nguyminhdc78-del/airpresenter-s3/enclosure/preview/bottom-shell.png

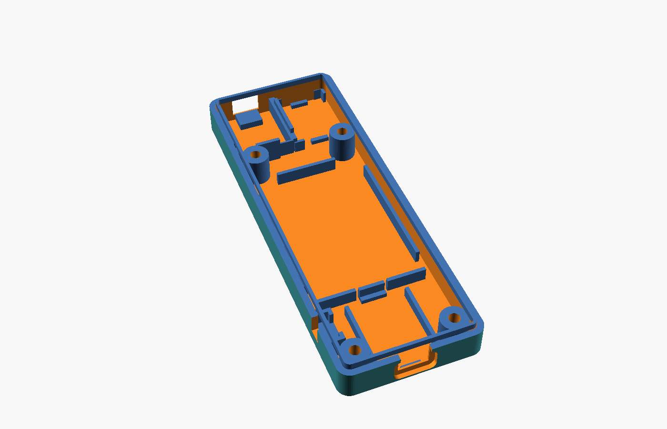
enclosure/preview/bottom-shell.png
