nguyminhdc78-del/airpresenter-s3/enclosure/preview/button-caps.png

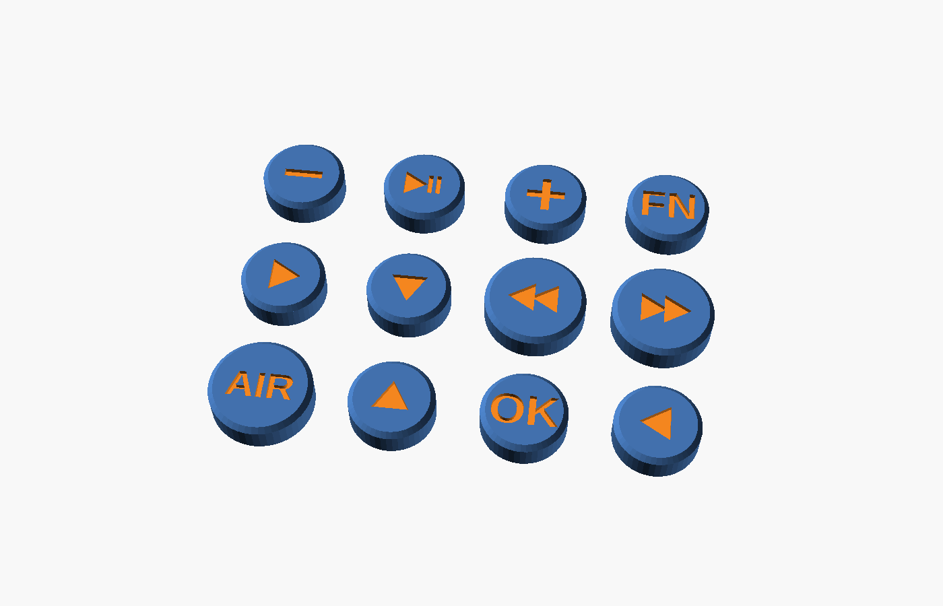
enclosure/preview/button-caps.png
