nguyminhdc78-del/airpresenter-s3/enclosure/preview/button-socket-section.png

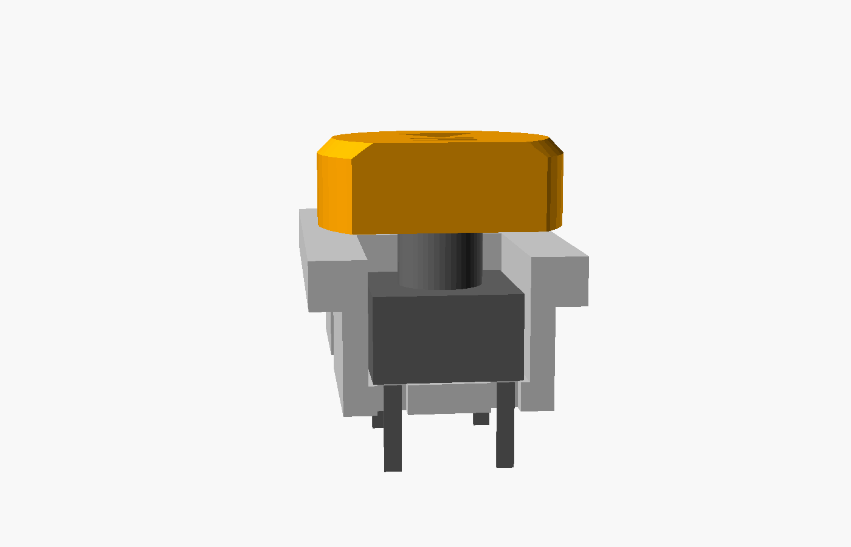
enclosure/preview/button-socket-section.png
