nguyminhdc78-del/airpresenter-s3/enclosure/preview/esp32-cradle.png

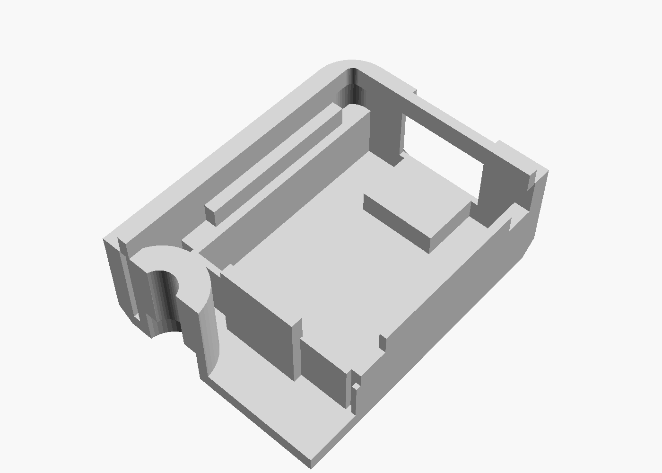
enclosure/preview/esp32-cradle.png
