nguyminhdc78-del/airpresenter-s3/enclosure/preview/esp32-mount-section.png

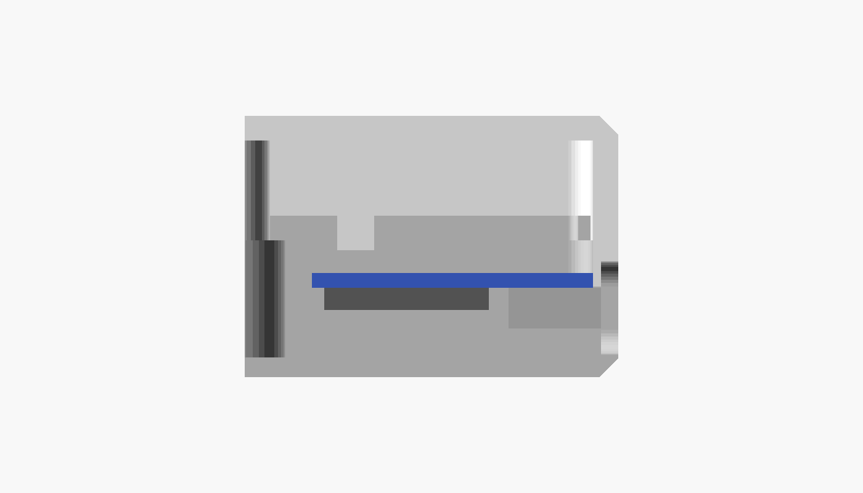
enclosure/preview/esp32-mount-section.png
