nguyminhdc78-del/airpresenter-s3/enclosure/preview/esp32-width-section.png

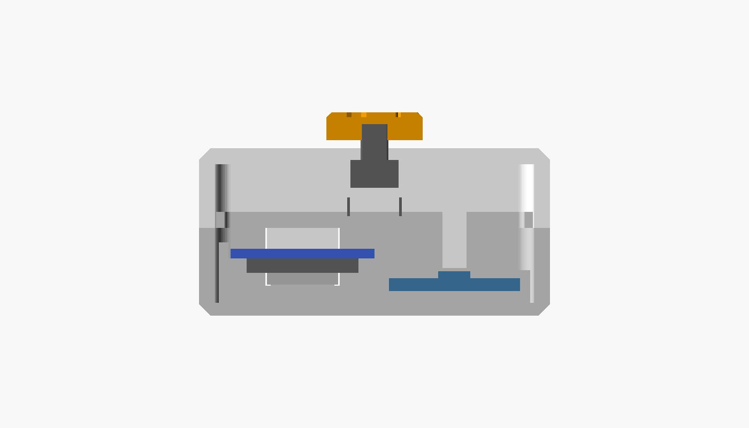
enclosure/preview/esp32-width-section.png
