nguyminhdc78-del/airpresenter-s3/enclosure/preview/exploded.png

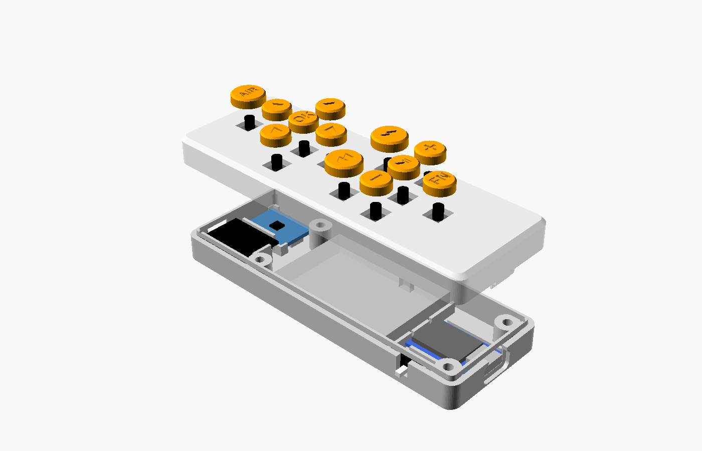
enclosure/preview/exploded.png
