nguyminhdc78-del/airpresenter-s3/enclosure/preview/layout-top.png

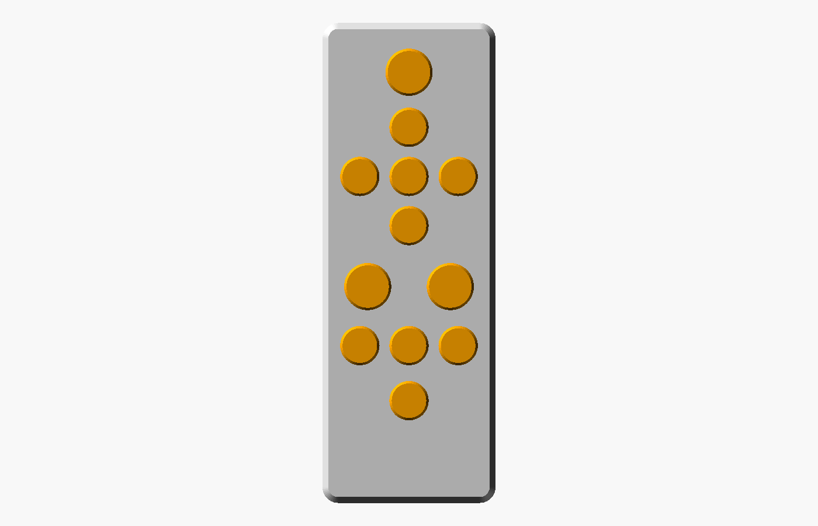
enclosure/preview/layout-top.png
