nguyminhdc78-del/airpresenter-s3/enclosure/preview/top-shell-underside.png

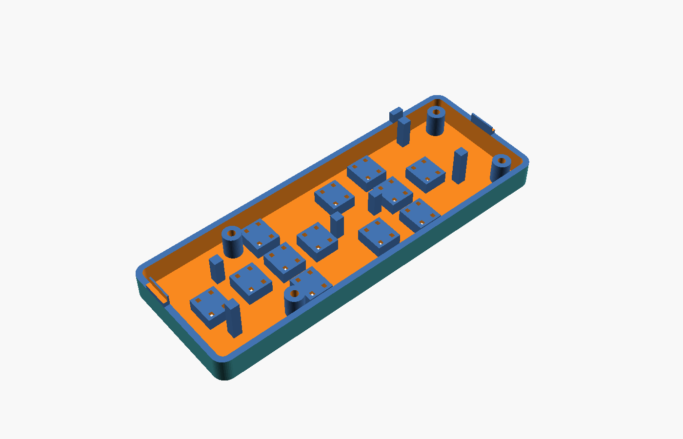
enclosure/preview/top-shell-underside.png
