nguyminhdc78-del/airpresenter-s3/product_image/5851bc56-0efb-418d-aecd-67ae6a5f5945.jpeg

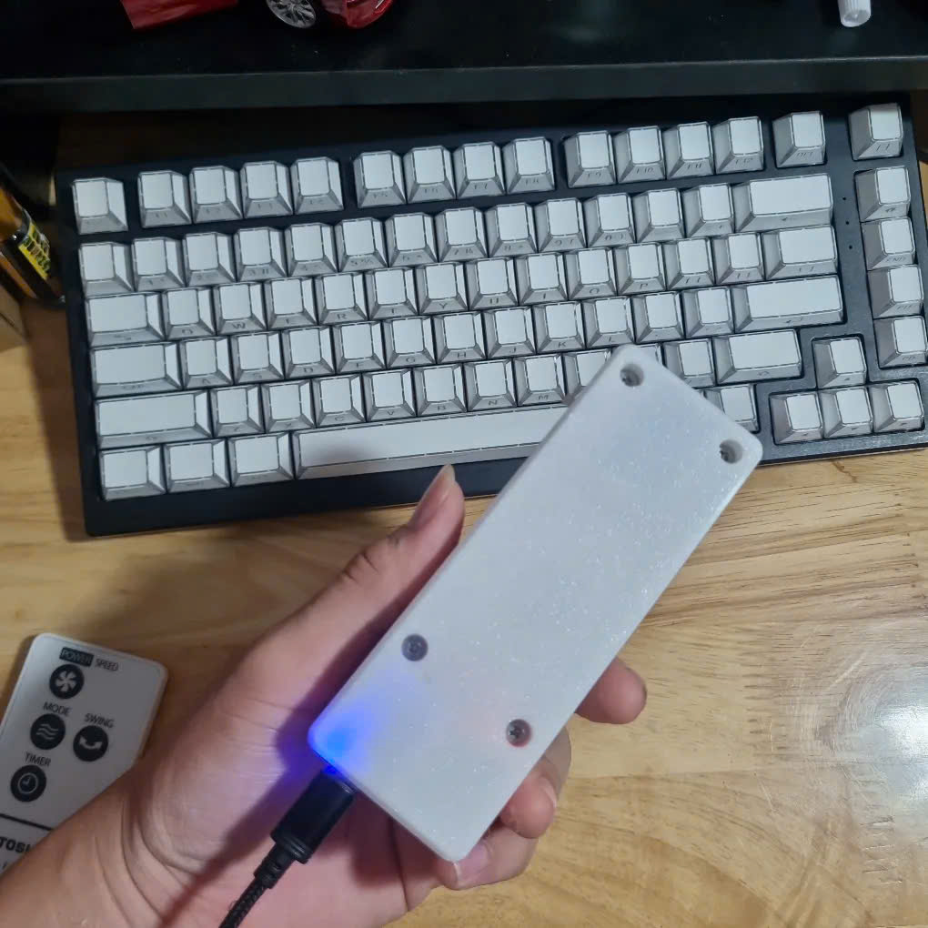
product_image/5851bc56-0efb-418d-aecd-67ae6a5f5945.jpeg
