nguyminhdc78-del/airpresenter-s3/enclosure/step/top-shell.step

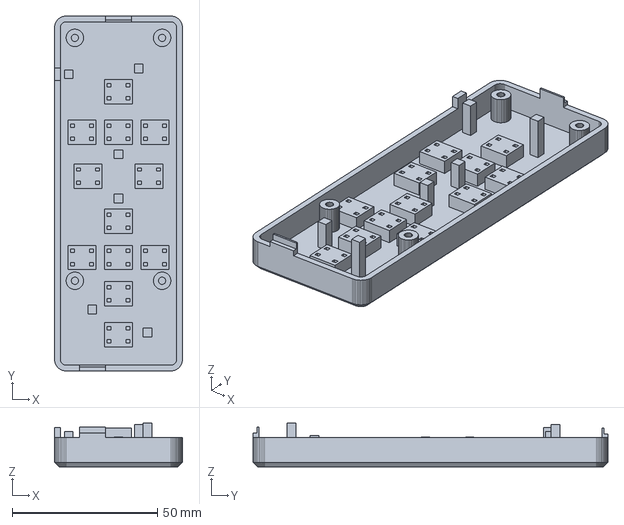
[picture p13: CAD file, 2026-10-25]
enclosure/step/top-shell.step
44.0 x 122.0 x 15.0 mm
