nguyminhdc78-del/airpresenter-s3/enclosure/stl/fit-test-coupon.stl

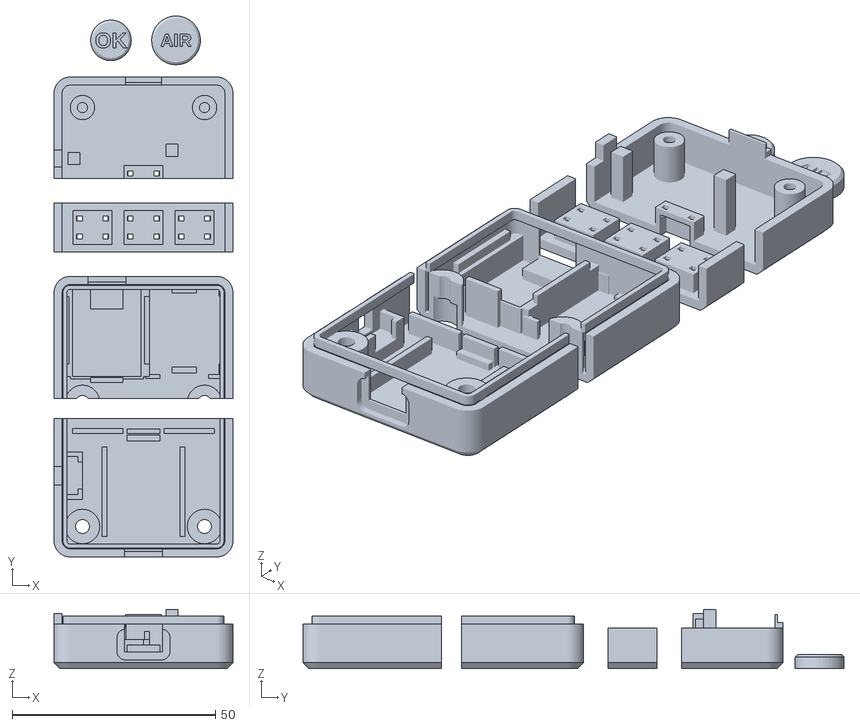
[picture p14: CAD file, 2026-10-25]
enclosure/stl/fit-test-coupon.stl
44.0 x 133.0 x 14.6
