nguyminhdc78-del/airpresenter-s3/enclosure/viewer/models/caps.stl

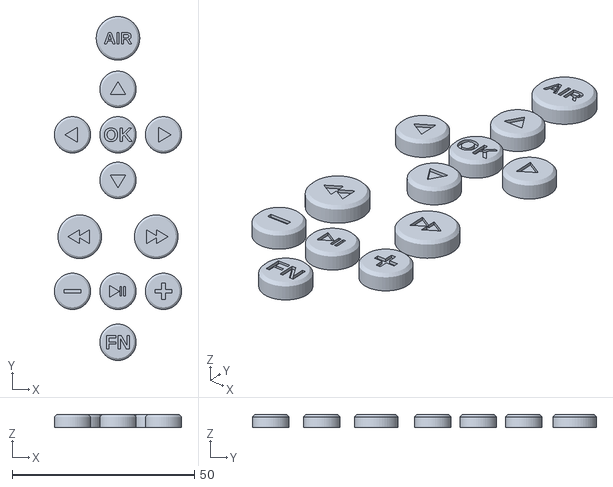
[picture p15: CAD file, 2026-10-25]
enclosure/viewer/models/caps.stl
35.0 x 94.5 x 3.50
