nguyminhdc78-del/airpresenter-s3/enclosure/step/button-caps.step

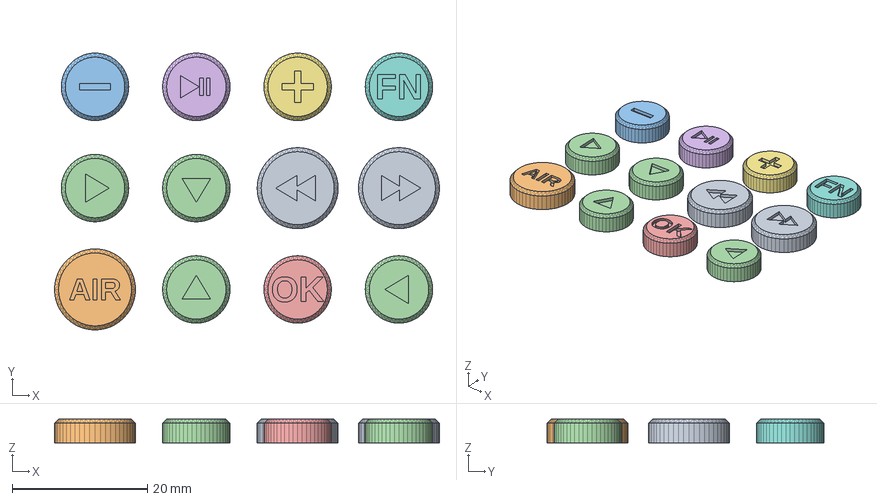
[picture p16: CAD file, 2026-10-25]
enclosure/step/button-caps.step
57.0 x 41.0 x 3.50 mm
button-caps 3.1
button-caps 3.2
button-caps 3.3
button-caps 3.4
button-caps 3.5
button-caps 3.6
button-caps 3.7
button-caps 3.8
button-caps 3.9
button-caps 3.10
button-caps 3.11
button-caps 3.12
