nguyminhdc78-del/airpresenter-s3/enclosure/viewer/models/power_switch.stl

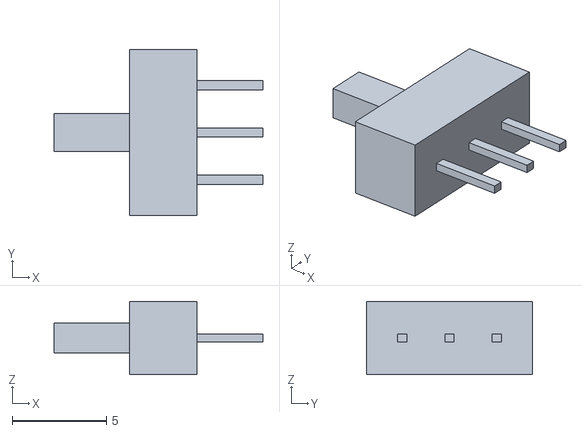
[picture p17: CAD file, 2026-10-25]
enclosure/viewer/models/power_switch.stl
11.1 x 8.80 x 3.90
