nguyminhdc78-del/airpresenter-s3/enclosure/step/bottom-shell.step

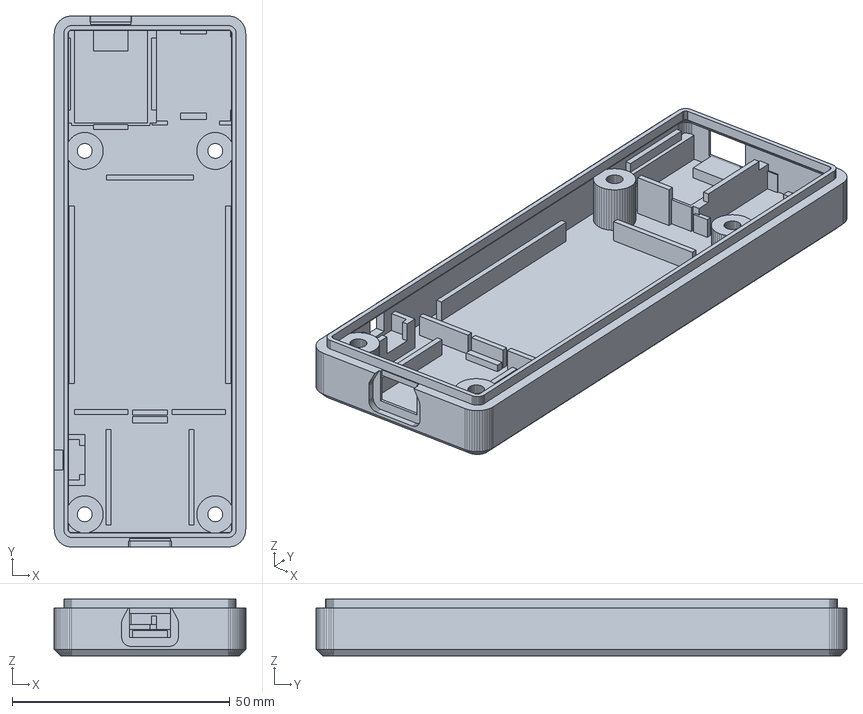
[picture p18: CAD file, 2026-10-25]
enclosure/step/bottom-shell.step
44.0 x 122.0 x 13.0 mm
