nguyminhdc78-del/airpresenter-s3/enclosure/viewer/models/charger.stl

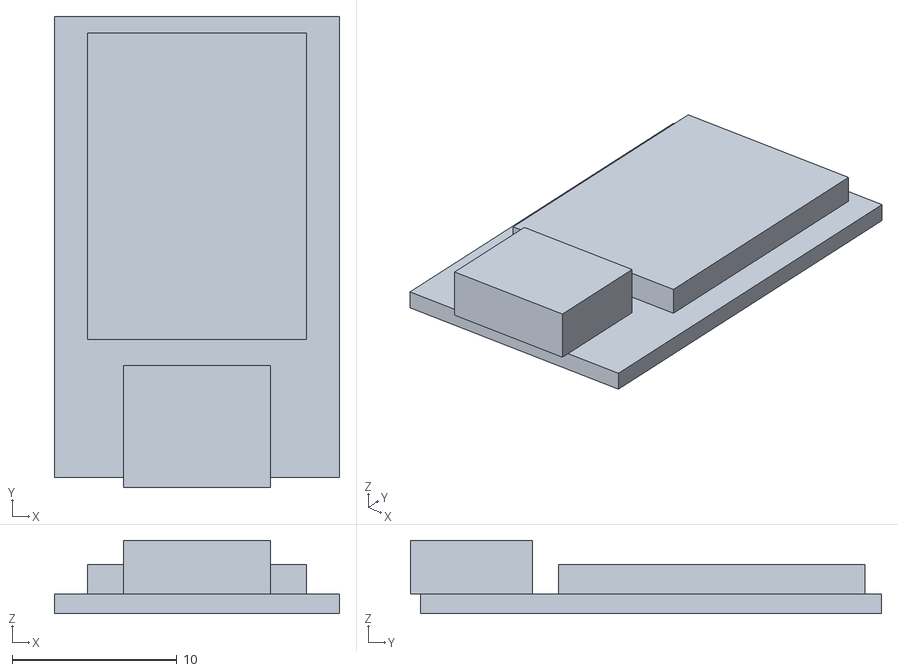
[picture p19: CAD file, 2026-10-25]
enclosure/viewer/models/charger.stl
17.3 x 28.6 x 4.46
