nguyminhdc78-del/airpresenter-s3/enclosure/viewer/models/esp32.stl

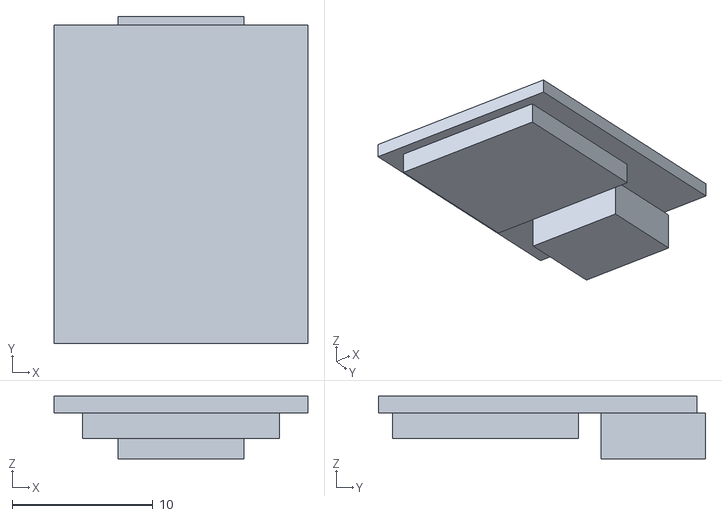
[picture p20: CAD file, 2026-10-25]
enclosure/viewer/models/esp32.stl
18.0 x 23.2 x 4.46
