nguyminhdc78-del/airpresenter-s3/enclosure/viewer/models/tact_switches.stl

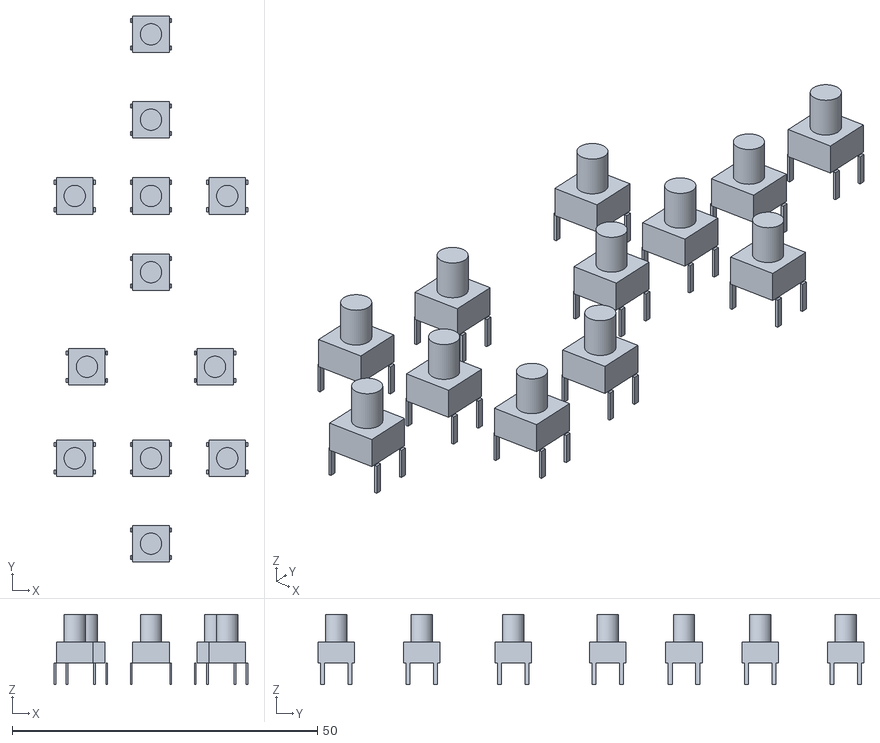
[picture p21: CAD file, 2026-10-25]
enclosure/viewer/models/tact_switches.stl
31.8 x 89.5 x 11.5
