nguyminhdc78-del/airpresenter-s3/enclosure/viewer/models/battery.stl

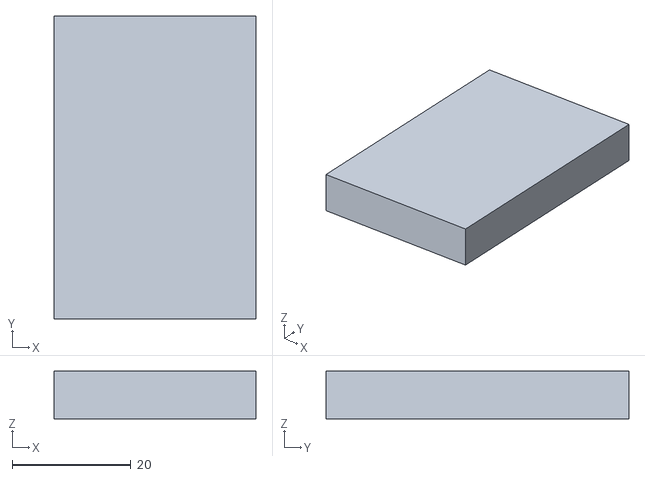
[picture p22: CAD file, 2026-10-25]
enclosure/viewer/models/battery.stl
34.0 x 51.0 x 8.00
