nguyminhdc78-del/airpresenter-s3/enclosure/viewer/models/gyro.stl

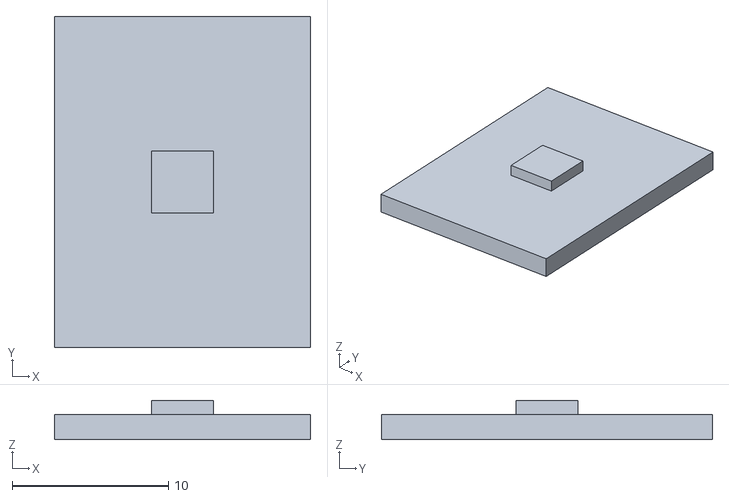
[picture p23: CAD file, 2026-10-25]
enclosure/viewer/models/gyro.stl
16.4 x 21.2 x 2.50
