nguyminhdc78-del/airpresenter-s3/(list of files, cad)

Other CAD files:
enclosure/viewer/models/top_shell.stl
enclosure/viewer/models/bottom_shell.stl
enclosure/stl/button-caps.stl
enclosure/stl/top-shell.stl
