nguyminhdc78-del/airpresenter-s3/enclosure/preview/assembly.png

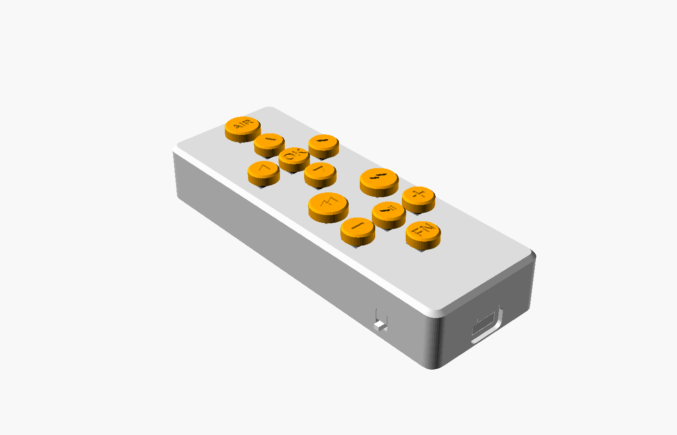
enclosure/preview/assembly.png
