nguyminhdc78-del/airpresenter-s3/enclosure/preview/fit-test-coupon.png

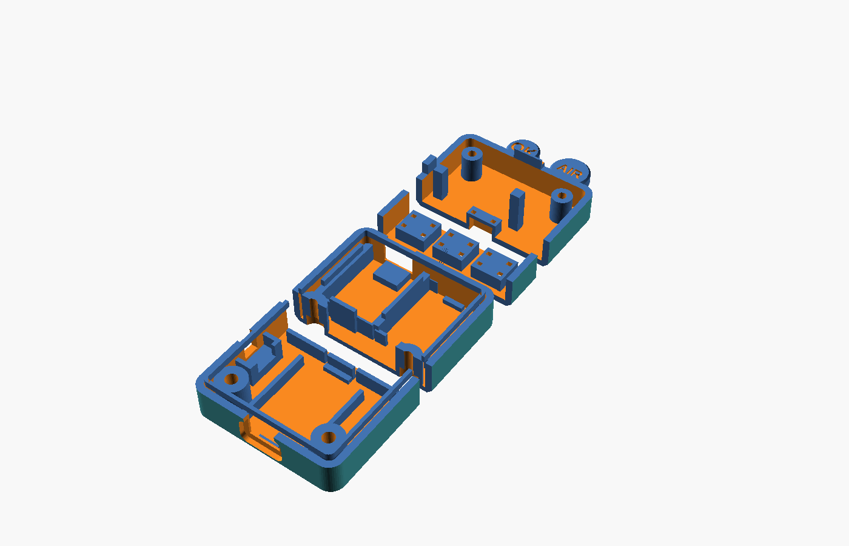
enclosure/preview/fit-test-coupon.png
