nguyminhdc78-del/airpresenter-s3/(commit log)

2026-10-25 docs: add wiring, firmware and enclosure assembly guides
2026-10-25 build: add PlatformIO config (ESP32-S3 SuperMini + native tests)
2026-10-25 feat(firmware): BLE HID presenter remote + gyro air mouse firmware
2026-10-25 test: add gyro bias tracker tests
2026-10-25 test: add IMU sample sanity tests
2026-10-25 feat(enclosure): parametric OpenSCAD enclosure
    [air-presenter-enclosure.scad, enclosure-board-cradles-and-usb-ports.scad, enclosure-bottom-shell.scad, enclosure-button-caps.scad, enclosure-component-mockups.scad, enclosure-fit-test-coupon.scad, enclosure-outer-body-and-split.scad, enclosure-parameters.scad]
2026-10-25 docs(enclosure): add preview renders
2026-10-25 feat(enclosure): add printable STL files
    [bottom-shell.stl, button-caps.stl, fit-test-coupon.stl, top-shell.stl]
2026-10-25 feat(enclosure): add STEP models for CAD editing
    [bottom-shell.step, button-caps.step, top-shell.step]
2026-10-25 feat(enclosure): add web 3D viewer
2026-10-25 feat(enclosure): add viewer models
    [battery.stl, bottom_shell.stl, caps.stl, charger.stl, esp32.stl, gyro.stl, power_switch.stl, tact_switches.stl]
2026-10-25 fix(enclosure): restore executable bit on viewer export script
